CalvEngIO/LiPoBBSupplyWithCharging/Docs/LiPoBBSupplyWithCharging-BOM.xlsx

@CalvEngIO LiPo Battery Breadboard Supply with Charging Rev E |  |  |  |  |  |  |  |  |  |  | Total | $6.40
BOM # | Comment | Designator | Description | Mounting Type | Package | Manufacturer | Manufacturer Part Number | Supplier | Supplier Part Number | Price per unit | Quantity | Price Total
1 | JST Connector | LIPO | JST Right Angle Connector - White | SMD | NA | 4UCOM Technology Inc. |  | Sparkfun Electronics | PRT-08612 | $0.95 | 1 | $0.95
2 | MCP73831 | CHRG | Charger IC Lithium-Ion/Polymer SOT-23-5 | SMD | SOT-23-5 | Microchip Technology | MCP73831T-2ACI/OT | Digi-Key | MCP73831T-2ACI/OTCT-ND | $0.58 | 1 | $0.58
3 | AP2210K-3.3V | LDO | Linear Voltage Regulator IC Positive Fixed 1 Output 3.3V 300mA SOT-23-5 | SMD | SOT-23-5 | Diodes Incorporated | AP2210K-3.3TRG1 | Digi-Key | AP2210K-3.3TRG1DICT-ND | $0.42 | 1 | $0.42
4 | Micro USB Female | USB | USB - micro B USB 2.0 Receptacle Connector 5 Position Surface Mount, Right Angle | SMD | 5-Pin-USB-Micro | Amphenol FCI | 10118192-0001LF | Digi-Key | 609-4613-1-ND | $0.46 | 1 | $0.46
5 | Schottky Diode | D3,D4 | Diode Schottky 30V 1.5A Surface Mount USC | SMD | USC | Toshiba Semiconductor and Storage | CUS15S30,H3F | Digi-Key | CUS15S30H3FCT-ND | $0.43 | 2 | $0.86
6 | Headers | J1,J2,J3 | 15/40 Positions Header, Breakaway Connector 0.100" (2.54mm) Through Hole Gold | THT | THT | Sullins Connector Solutions | PRPC040SAAN-RC | Digi-Key | S1011EC-40-ND | $0.28 | 1 | $0.28
7 | Switch | SWITCH | SWITCH SLIDE DPDT 300MA 6V | SMD | J Lead | C&K | JS202011JCQN | Digi-Key | CKN10723CT-ND | $0.48 | 1 | $0.48
8 | Shunt | J1 | 2 (1 x 2) Position Shunt Connector Black Open Top 0.100" (2.54mm) Gold | NA | NA | Sullins Connector Solutions | QPC02SXGN-RC | Digi-Key | S9337-ND | $0.13 | 1 | $0.13
9 | Green LED | D1,D2,PWR | Green 571 nm, 2 V | SMD | 0603 | Lite-On Inc | LTST-C190KGKT | Digi-Key | 160-1435-1-ND | $0.27 | 3 | $0.81
10 | 2.2uF capacitor | C1,C2,C4,C5,C8 | 16V, X5R | SMD | 0603 | Murata Electronics North America | GRM188R61C225KE15D | Digi-Key | 490-3296-1-ND | $0.13 | 5 | $0.65
11 | 4.7uF capacitor | C6,C7 | 4.7µF ±10% 10V Ceramic Capacitor X5R 0603 (1608 Metric) | SMD | 0603 | Samsung Electro-Mechanics America, Inc. | CL10A475KP8NNNC | Digi-Key | 1276-1044-1-ND | $0.14 | 2 | $0.28
12 | 100pF | C3 | 100pF ±5% 50V Ceramic Capacitor C0G, NP0 0402 (1005 Metric) | SMD | 0402 | Samsung Electro-Mechanics America, Inc. | CL05C101JB5NNNC | Digi-Key | 1276-1025-1-ND | $0.10 | 1 | $0.10
13 | 1.02k resistor | R1,R2,R3 | RES SMD 1.02K OHM 1% 1/16W 0402 | SMD | 0402 | Yageo | RC0402FR-071K02L | Digi-Key | YAG3029CT-ND | $0.10 | 3 | $0.30
14 | 10.2k resistor | R3 | 10.2k Ohm ±1% 0.063W, 1/16W Chip Resistor 0402 (1005 Metric) Moisture Resistant Thick Film | SMD | 0402 | Yageo | RC0402FR-0710K2L | Digi-Key | YAG2950CT-ND | $0.10 | 1 | $0.10
