CalvEngIO/LiPoBBSupplyWithCharging/Hardware/LiPoBBSupplyWithCharging.brd

## EAGLE design Hardware/LiPoBBSupplyWithCharging.brd (2017-07-28)

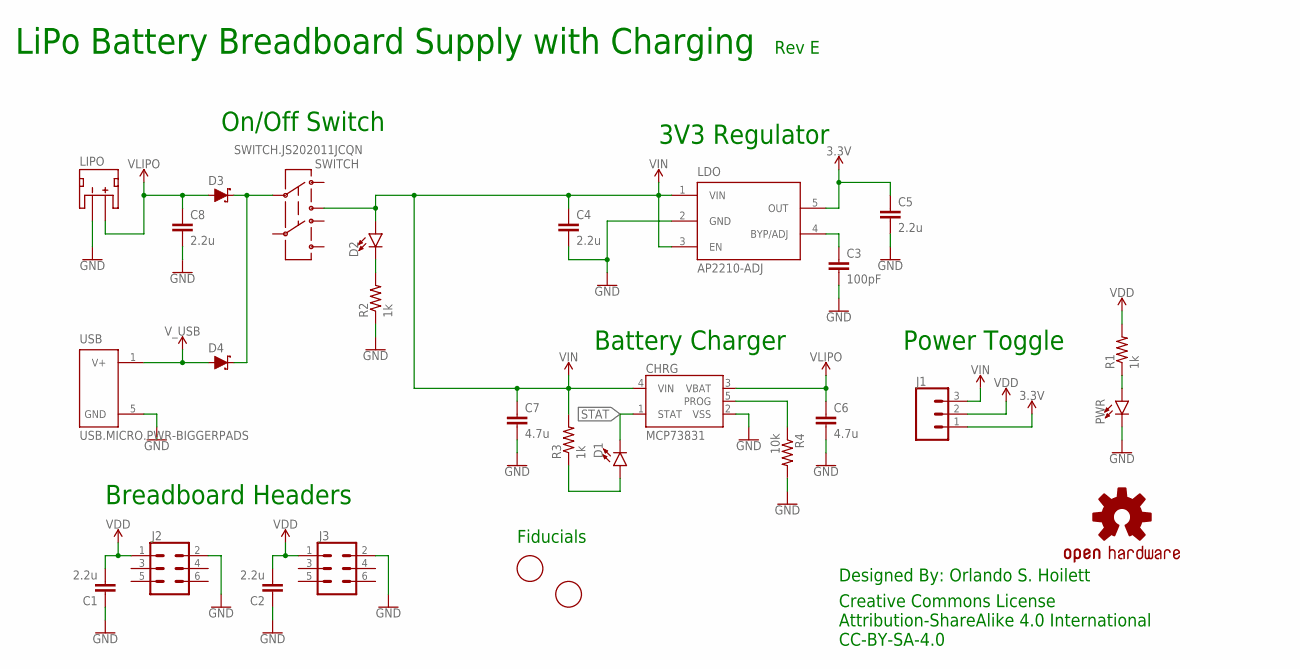
[picture p1: schematic LiPoBBSupplyWithCharging.sch]

Parts:
C1, C2, C4, C5, C8: 2.2u; C0603
C3: 100pF; C0402
C6, C7: 4.7u; C0603
CHRG: MCP73831; SOT23-5
D1, D2: LED0603; LED-0603
D3, D4: SCHOTTKY-USC; USC
FD1, FD2: FIDUCIAL; FIDUCIAL_1MM
J1: CONN_03; 1X03
J2, J3: CONN_03X22X3_SILK_MALE_PTH; 2X3
LDO: AP2210-ADJ; SOT23-5
LIPO: JST_2MM_MALE; JST-2-SMD
LOGO1: OSHW-LOGOS; OSHW-LOGO-S
PWR: LED0603; LED-0603
R1, R2, R3: 1k; R0402
R4: 10k; R0402
SWITCH: SWITCH.JS202011JCQN; SWITCH.00
U$1: HANDLE.1HANDLE.025; HANDLE.025
U$3: CALVENGIO_HANDLEHANDLE.1; CALVENGIO_HANDLE.1
USB: USB.MICRO.PWR-BIGGERPADS; USB-MICRO-01.BIGGERPADS.PWR

Connections:
3.3V: C5.1, J1.1, LDO.5 (OUT)
GND: C1.1, C2.1, C3.2, C4.2, C5.2, C6.2, C7.2, C8.2, CHRG.2 (VSS), J2.2, J3.2, LDO.2 (GND), LIPO.1 (-), PWR.C, R2.1, R4.2, USB.5 (GND)
unnamed: PWR.A, R1.1
unnamed: D2.C, R2.2
unnamed: C3.1, LDO.4 (BYP/ADJ)
unnamed: D1.A, R3.1
unnamed: CHRG.5 (PROG), R4.1
unnamed: D3.- (C), D4.- (C), SWITCH.2
STAT: CHRG.1 (STAT), D1.C
VDD: C1.2, C2.2, J1.2, J2.1, J3.1, R1.2
VIN: C4.1, C7.1, CHRG.4 (VIN), D2.A, J1.3, LDO.1 (VIN), LDO.3 (EN), R3.2, SWITCH.3
VLIPO: C6.1, C8.1, CHRG.3 (VBAT), D3.+ (A), LIPO.2 (+)
V_USB: D4.+ (A), USB.1 (V+)

Notes on the sheet:
Breadboard Headers
Power Toggle
3V3 Regulator
On/Off Switch
Fiducials
Creative Commons License Attribution-ShareAlike 4.0 International CC-BY-SA-4.0
Designed By: Orlando S. Hoilett
LiPo Battery Breadboard Supply with Charging
Battery Charger
Rev E

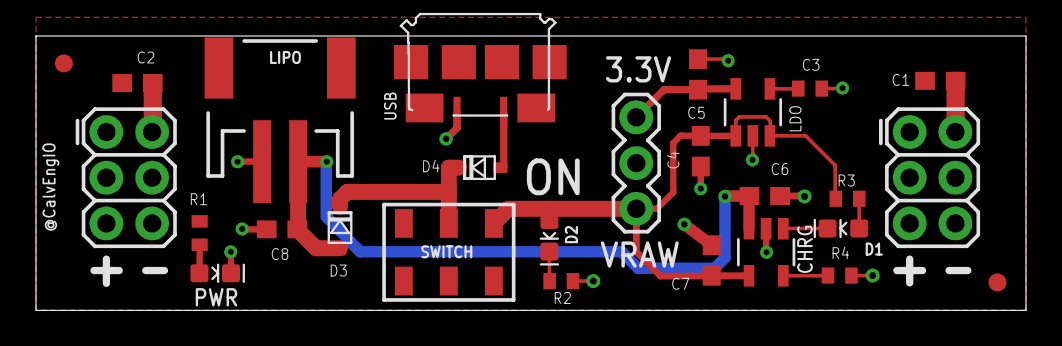
[picture p2: board Hardware/LiPoBBSupplyWithCharging.brd from above]

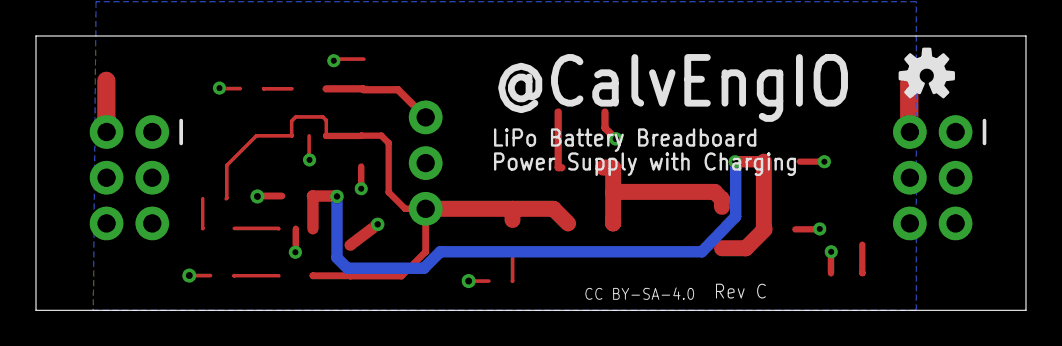
[picture p3: board Hardware/LiPoBBSupplyWithCharging.brd from below]

Board: 2 copper layers, 55.0 x 15.2 mm, 30 parts (2 on the bottom side), 13 nets.
